Lambchops118/Pump-Power-Controller/Hardware/Controller_Board_mk2.kicad_pcb

## KiCad design Hardware/Controller_Board_mk2.kicad_pcb (2026-07-09)

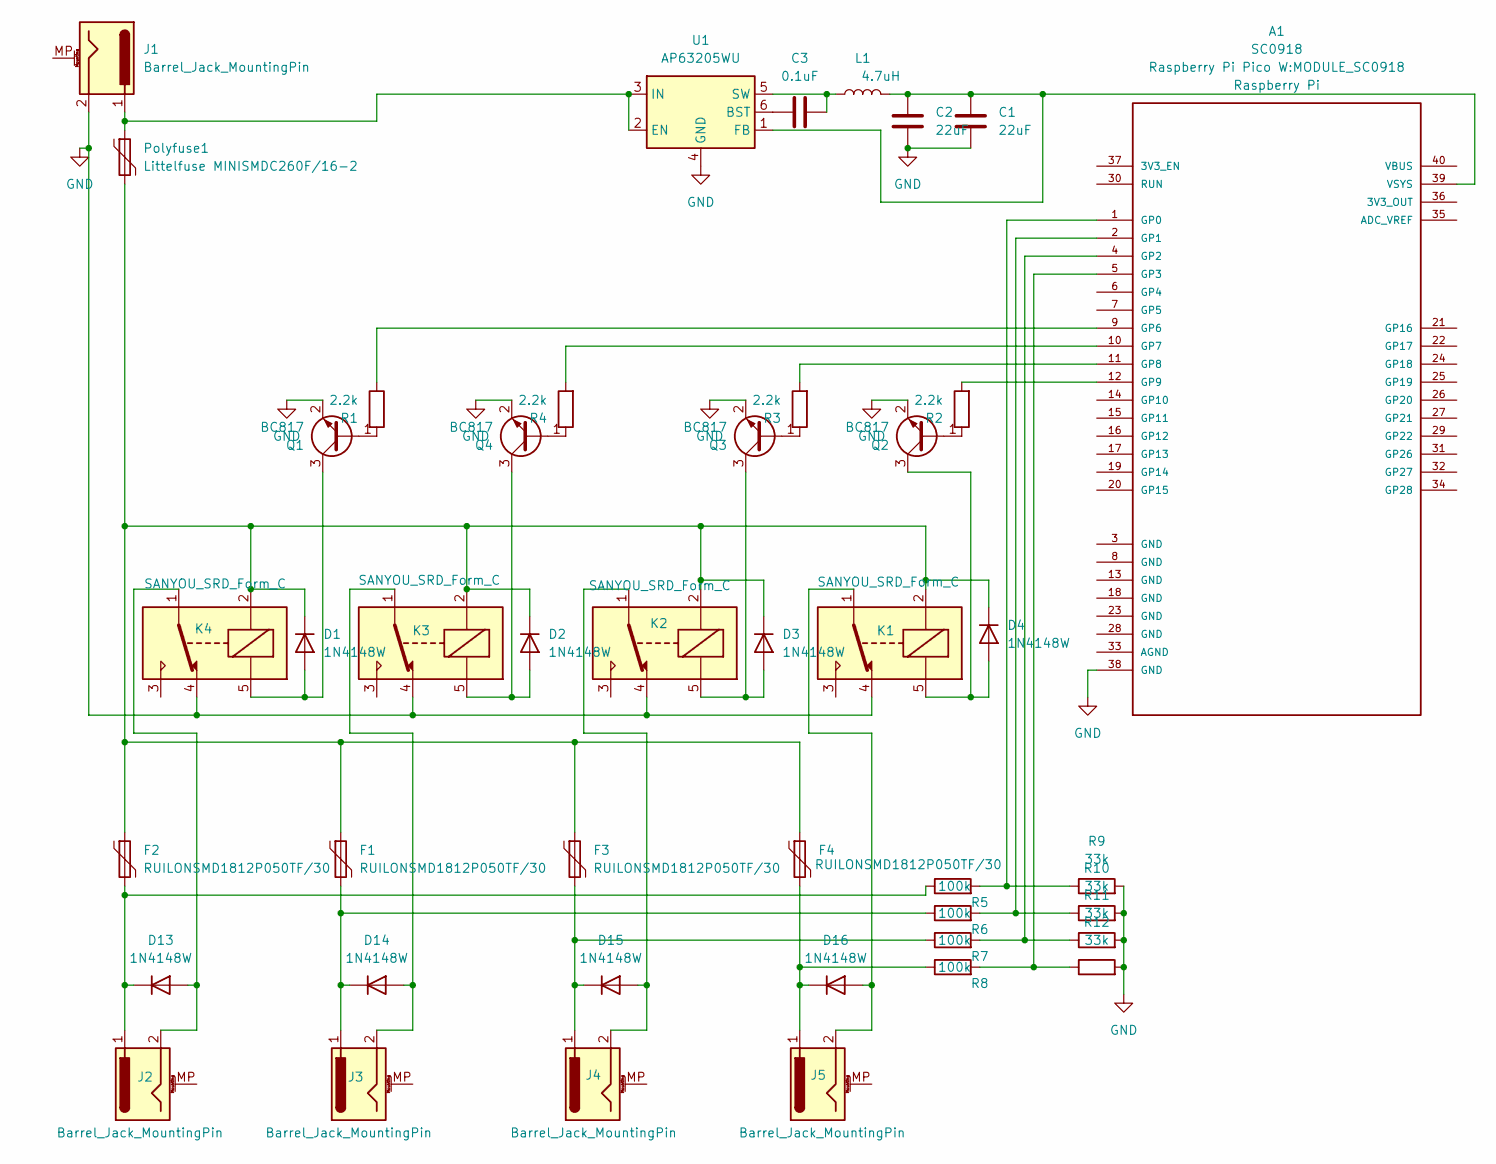
[picture p1: schematic Controller_Board_mk2.kicad_sch]

Parts:
A1: SC0918; MODULE_SC0918; PARTREV 1.6; LCSC C7203003
C1, C2: 22uF; R_0603_1608Metric; LCSC C59461
C3: 0.1uF; R_0603_1608Metric; LCSC C14663
D1, D2, D3, D4, D13, D14, D15, D16: 1N4148W; D_SOD-123; LCSC C81598
F1, F2, F3, F4: RUILONSMD1812P050TF/30; Fuse_1812_4532Metric; JLCPCB C12559
J1, J2, J3, J4, J5: Barrel_Jack_MountingPin; BarrelJack_CUI_PJ-102AH_Horizontal
K1, K2, K3, K4: SANYOU_SRD_Form_C; Relay_SPDT_SANYOU_SRD_Series_Form_C
L1: 4.7uH; C_1206_3216Metric; LCSC C1034
Polyfuse1: Littelfuse MINISMDC260F/16-2; Fuse_1812_4532Metric; JLCPCB C16490
Q1, Q2, Q3, Q4: BC817; SOT-23; LCSC C2145
R1, R2, R3, R4: 2.2k; R_0603_1608Metric; LCSC C4190
R5, R6, R7, R8: 100k; R_0603_1608Metric; JLCPCB C25803
R9, R10, R11, R12: 33k; R_0603_1608Metric; JLCPCB C4216
U1: AP63205WU; TSOT-23-6; LCSC C2071056

Connections:
GND: A1.38 (GND), C1.2, C2.2, J1.2, K1.4, K2.4, K3.4, K4.4, Q1.2 (E), Q2.2 (E), Q3.2 (E), Q4.2 (E), R9.2, R10.2, R11.2, R12.2, U1.4 (GND)
unnamed: A1.1 (GP0), R5.2, R9.1
unnamed: A1.2 (GP1), R6.2, R10.1
unnamed: A1.4 (GP2), R7.2, R11.1
unnamed: A1.5 (GP3), R8.2, R12.1
unnamed: A1.9 (GP6), R1.1
unnamed: A1.10 (GP7), R4.2
unnamed: A1.11 (GP8), R3.2
unnamed: A1.12 (GP9), R2.2
unnamed: A1.39 (VSYS), C1.1, C2.1, L1.2, U1.1 (FB)
unnamed: D1.2 (A), K4.5, Q1.3 (C)
unnamed: D1.1 (K), D2.1 (K), D3.1 (K), D4.1 (K), F1.1, F2.1, F3.1, F4.1, K1.2, K2.2, K3.2, K4.2, Polyfuse1.2
unnamed: D2.2 (A), K3.5, Q4.3 (C)
unnamed: D3.2 (A), K2.5, Q3.3 (C)
unnamed: D4.2 (A), K1.5, Q2.3 (C)
unnamed: D13.2 (A), J2.2, K4.1
unnamed: D13.1 (K), F2.2, J2.1, R5.1
unnamed: D14.2 (A), J3.2, K3.1
unnamed: D14.1 (K), F1.2, J3.1, R6.1
unnamed: D15.2 (A), J4.2, K2.1
unnamed: D15.1 (K), F3.2, J4.1, R7.1
unnamed: D16.2 (A), J5.2, K1.1
unnamed: D16.1 (K), F4.2, J5.1, R8.1
unnamed: Q1.1 (B), R1.2
unnamed: Q2.1 (B), R2.1
unnamed: Q3.1 (B), R3.1
unnamed: Q4.1 (B), R4.1
unnamed: C3.1, U1.6 (BST)
unnamed: J1.1, Polyfuse1.1, U1.2 (EN), U1.3 (IN)
unnamed: C3.2, L1.1, U1.5 (SW)

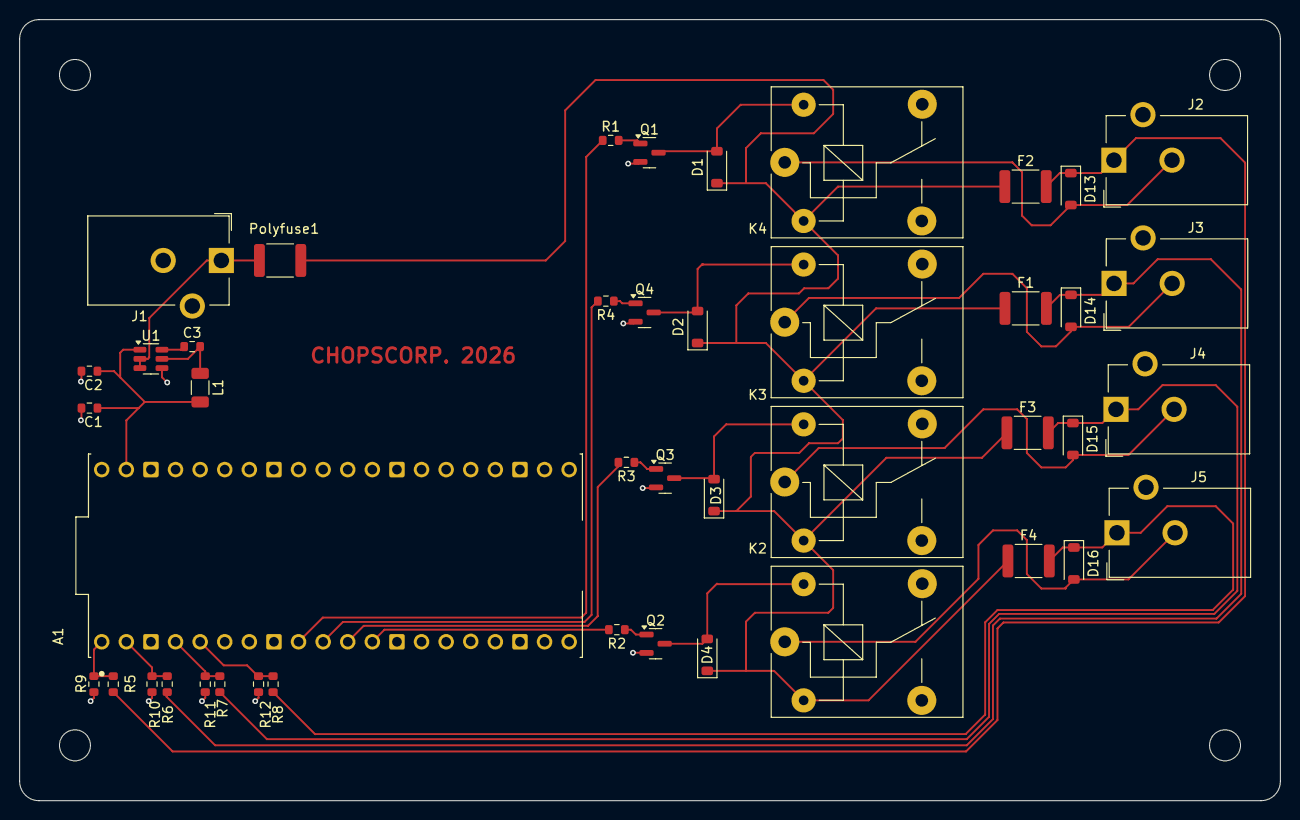
[picture p2: board Controller_Board_mk2.kicad_pcb from above]

Board: 2 copper layers, 130.2 x 80.6 mm, 44 parts (0 on the bottom side), 30 nets.
