Lambchops118/Pump-Power-Controller/(commit log)

2026-07-08 Redid schematic and added fuse sensors
    [Controller_Board_mk2.csv, Controller_Board_mk2.kicad_pcb, Controller_Board_mk2.kicad_sch]
2026-07-09 routed mostly everything and fixed some minor errors
    [Controller_Board_mk2.kicad_pcb, Controller_Board_mk2.kicad_sch]
2026-07-09 finished routing board, added vias, added gnd plane
    [Controller_Board_mk2.kicad_pcb]
2026-07-09 added connection from U1 ground to gnd plane
    [Controller_Board_mk2.kicad_pcb]
2026-07-09 added silkscreen to text so it shows up in bare copper
    [Controller_Board_mk2.kicad_pcb]
2026-07-09 minor trace fixes
    [Controller_Board_mk2.kicad_pcb]
2026-07-09 added through holes, reworked copper pour and edge cuts.
    [Controller_Board_mk2.kicad_pcb]
2026-07-09 added some LCSC part numbers in the schematic
    [Controller_Board_mk2.kicad_sch]
2026-07-09 minor fixes
    [Controller_Board_mk2.kicad_pcb]
2026-08-08 Commit mark 3 to main. added firmware to repo
    [Controller_Board_mk2.csv, Controller_Board_mk2.kicad_pcb, Controller_Board_mk2.kicad_sch]
2026-08-28 fixed bug where mulitple pump requests wouldnt queue
    [main.py, qp_config.py, qp_controller.py]
2026-08-28 quad pump change
2026-08-28 fixed pump fw
